pattyka/plasmapen-nexus/tools/out/f_bottom.png

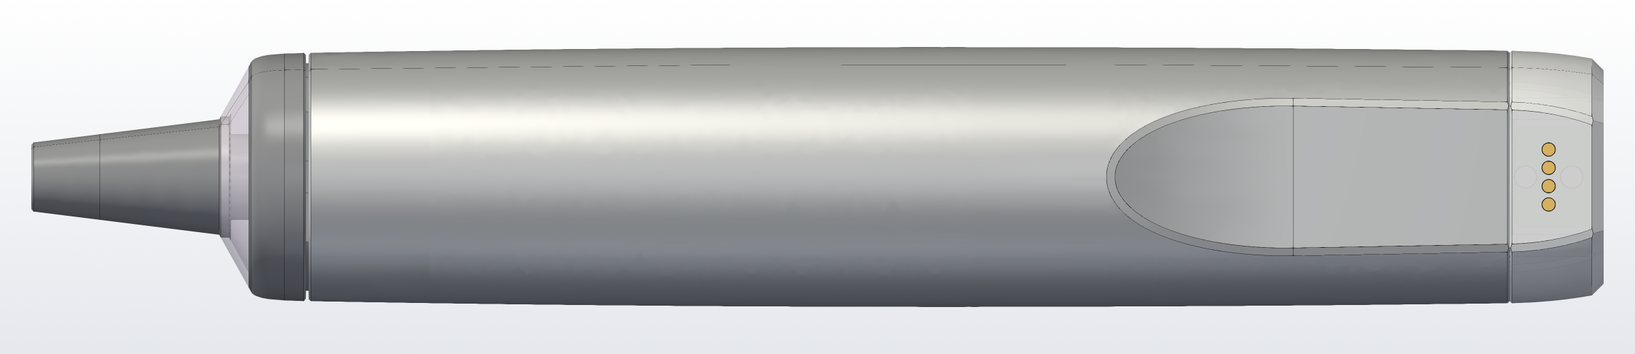
tools/out/f_bottom.png
