pattyka/plasmapen-nexus/tools/out/b_cutaway_side.png

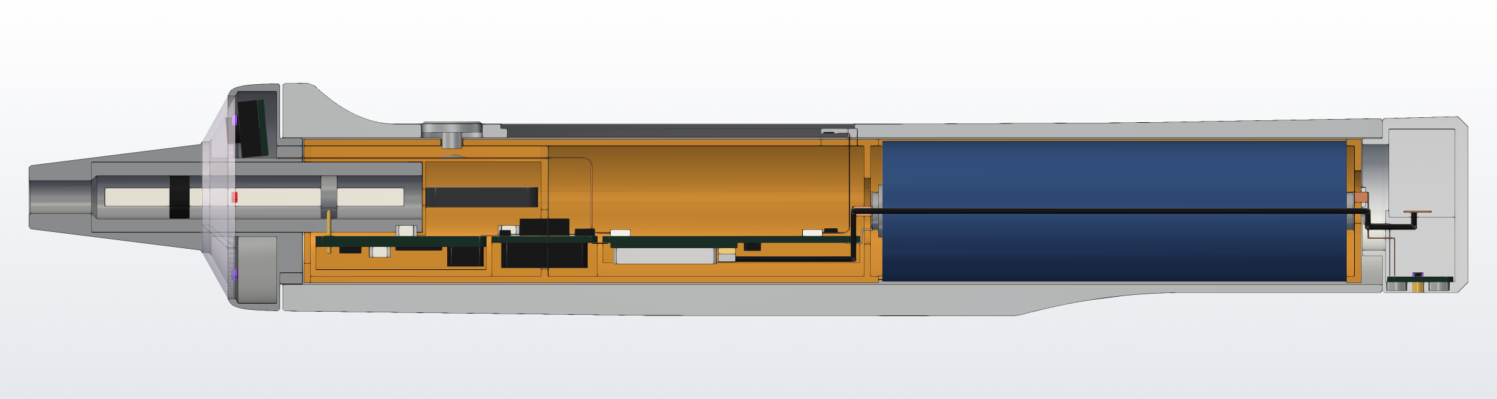
tools/out/b_cutaway_side.png
