pattyka/plasmapen-nexus/BRIEF.md

# PlasmaPen Nexus — shared brief for every builder

Goal: a parametric Autodesk Fusion model of the PlasmaPen Nexus (handheld cold-plasma wound pen,
see the pitch summary below), generated by a Fusion Python script. ONE Fusion design contains:
  • "működés" (render) assembly — pen pointing down at a petri dish, plasma plume on, LEDs glowing
  • "engineering" assembly — same pen lying horizontal, shells cut in half (z > 0 removed) so the
    internals are visible. Internal parts are SHARED components (same component, second occurrence),
    shells are built twice (once whole, once cut).
Quality bar: Apple-grade industrial design, real part dimensions, renders that look like a product
page. Plain, restrained, no fake detail. Production-ready code: no TODOs, no stubs.

Pitch facts: 280 g target, 5–8 W, < 38 °C plasma, TDK CeraPlas piezo, 405 nm blue LED (+ 660 nm
aux) excites porphyrin (red) / pyoverdine (green) fluorescence, Omnivision OV5640 camera + filter
in the head, ESP32-S3 (BLE) does closed-loop dosing, one button, 21700 Li-ion 4800 mAh, CNC
aluminium body + PEEK head. Demo: KI-starch strip, BSL-1 agar plate (E. coli K-12 / B. subtilis).
Revision 4 deviations (reasons in "REVISION 4"): CeraPlas HF instead of F (5 W), 1.91" touch
AMOLED instead of the 0.96" OLED, no USB-C (4-pad dock), two galvanically separated boards.

## Files (folder ~/Documents/PlasmaPen/)
  PlasmaPenNexus/PlasmaPenNexus.py   Fusion entry point / orchestrator (owner: lead)
  PlasmaPenNexus/pp_params.py        ALL user parameters (owner: lead) — read it first
  PlasmaPenNexus/pp_core.py          Backend interface + FusionBackend (owner: agent K) — read it
  PlasmaPenNexus/pp_shell.py         Package S — alu housing, end cap, cover glass, button
  PlasmaPenNexus/pp_head.py          Package H — PEEK nose cone, HV liner, piezo, optics
  PlasmaPenNexus/pp_insert.py        Package H — PEI insert (sled), bulkheads, shield foil
  PlasmaPenNexus/pp_electronics.py   Package E — boards, display, cell, blower, dock, antenna
  PlasmaPenNexus/pp_scene.py, pp_looks.py, assets/oled_ui.png   (unchanged; looks: see below)
  tools/preview_backend.py, tools/preview.py, tools/check.py    preview + checks (agent K)
  pp_body.py, pp_internals.py are REVISION 3 and obsolete: no list loads them. Delete them once
  pp_shell / pp_insert / pp_electronics exist (lead). tools/head_section.py and
  tools/internals_check.py import pp_body and die with it.

## Rules for builder modules (S, H, E)
- Import only `pp_core` helpers (`neg`, `Op`) and talk only to the `bk` Backend object. NEVER import
  adsk. Never call methods not in the Backend interface. Do not import another builder module.
- Every size/coordinate is a Fusion expression string built from parameter names in pp_params.py.
  Every literal length carries " mm" ("2.5 mm"), angles " deg". Unitless counts are bare.
- If you need a NEW parameter, do NOT edit pp_params.py. Declare it in your module as
      EXTRA_PARAMS = [("name", "expr", "mm", "Rövid magyar komment"), ...]
  (prefix names with your module: shell_*, head_*, ins_*, el_*, scene_*). Expressions may reference
  pp_params names and your own earlier EXTRA_PARAMS only — never another module's. A module check
  is named <prefix>_chk_* and must stay ≥ 0 (the orchestrator and check.py report every chk).
- Profiles are closed loops in the component XY plane (see pp_core docstring). Fully think through
  the geometry: no zero-length segments, no self-intersection, no coincident duplicate vertices,
  no point that changes side of an axis when parameters vary over the check.py variants.
- Revolve profiles about the X axis must lie entirely at y ≥ 0 and touch y = 0 only on purpose.
- Name every component and body in short Hungarian (e.g. "Orrkúp (PEEK)", "Üveggyűrű"), like Apple
  would label parts: plain nouns. Component names listed in the contracts below are fixed
  (check.py matches some of them).
- Looks / materials: use keys from this list (pp_looks.py):
    looks:     alu, alu_dark, peek, pei (amber translucent insert), glass_window (violet-tint
               clear ring), glass_black (cover glass), glass_frost (end cap light guide), lens,
               led405, led660, plasma_core, plasma_halo, spot405, ceramic, pcb, shield, copper,
               gold, steel, battery_wrap, plastic_black, plastic_white, rubber, fan, agar, petri,
               oled_on
    materials: aluminum, peek, pei, glass, plastic, steel, copper, fr4, battery
- Pass pen=False for scene bodies (plume, dish, agar, spot) so they stay out of the mass report.
- Edge breaks: `bk.fillet(comp, name, body, edges, radius)` and
  `bk.chamfer(comp, name, body, edges, distance)` (equal distance). Both take the same selector
  list, chain tangent edges, and are cosmetic: a failure is logged, returns None, never stops the
  build. Selectors (tolerance 0.05 mm, only edges of `body`):
    ("circle", x, r)          arc/circle centred on the X axis at x, radius r
    ("line_y", x, z) / ("line_x", y, z)   straight edge parallel to Y / X through that point
    ("plane_y", y)            every edge lying entirely in the plane y = value
    ("plane_y", y, 1 | -1)    … only on the z > 0 / z < 0 side (an edge on z = 0 is excluded)
    ("op_edges", op)          every edge bounding a face that `op` (an Op you got back earlier,
                              e.g. the cut that made the facet) created, looked up when the
                              fillet/chamfer runs, so later ops are followed
    ("op_edges", op, "outer") … only where those faces meet the rest of the body: the rim of a
                              sliced flat or pocket, without the edges inside the pocket
    ("plane_x", x)            every edge lying entirely in the plane x = value
    ("minus", sel_a, sel_b)   what sel_a matches minus what sel_b matches, e.g. a facet rim
                              without its edge on the joint face
  Keep the Op of every cut you want to break later (`flat = bk.box(..., op="cut", ...)`).
- `bk.count(expr)` → int value of a unitless parameter now, for a row of N features in a loop
  (dock pads). Fusion moves them on a later parameter edit but never adds or removes one.
- Edges the revolve profile can carry (joint chamfers, the Kamm chamfer at the tail) go INTO the
  profile as a 45° segment, not into a chamfer feature: it cannot fail.

## Module contracts
  pp_shell.py:       build_shell(bk, parent, cutaway) -> ["Ház (alu)", "Hátsó kupak (PC)",
                                                          "Fedőüveg"]
                     build_shared(bk, parent) -> ["Gomb"]
                     outer_r(x) -> str   Fusion expression of the housing/cap outer radius at x
                                         (formula in "Outer form"), for nose_split ≤ x ≤ pen_len
  pp_head.py:        build_shell(bk, parent, cutaway) -> ["Orrkúp (PEEK)", "HV bélés (PEEK)"]
                     build_shared(bk, parent) -> ["Üveggyűrű", "LED 405 nm", "LED 660 nm",
                                                  "Kamera (OV5640)", "CeraPlas HF"]
  pp_insert.py:      build_shell(bk, parent, cutaway) -> ["Betét (PEI)"]
                     build_shared(bk, parent) -> ["Árnyékolás"]
  pp_electronics.py: build_shared(bk, parent) -> ["Plazma NYÁK", "Ventilátor", "Vezérlő híd",
                     "AI NYÁK", 'AMOLED 1,91"', "Akku 21700", "Dokk NYÁK", "Dokk érintkezők",
                     "Mágnesek", "BLE antenna"]
  pp_scene.py:       build_scene(bk, parent) -> list[comp]   (render assembly only, unchanged)
  Build order (orchestrator and preview): build_shell of pp_shell, pp_head, pp_insert; then
  build_shared of pp_shell, pp_head, pp_insert, pp_electronics; then the scene. Engineering copy:
  build_shell(cutaway=True) of the same three + a second occurrence of every shared component.
  When cutaway is True, after building, call bk.cut_half(comp, "Metszet", [bodies...]).

## REVISION 4 — what Patrik asked for (2026-10-21)
Rejected revision 3 (Ø29 spindle, 1.1" strip, rounded facet). Wants: Pininfarina method, thicker
body with substance (several cm if engineering-real, not a writing pen), a long cylinder
(toilet-paper roll) with the TOP sliced flat for a substantial touch AMOLED and the BOTTOM sliced
flat for pogo-pin dock contacts, CHAMFERED edges, a very elegant end cap, streamlined / organic /
dynamic (may look generative). Two-part device: the case, and inside it a separately built PLASTIC
INSERT that slides in; inside the insert physically separated electronics for (1) the AI camera
and (2) the plasma, two complete boards talking through an integrated controller; the plastic
insulates the user from a short. Display under the THUMB, visible during use. Apple product, not
homemade. Parametric, so the inside survives parameter changes.

## REVISION 4 — research
Pininfarina, sourced (statements) → the rule we apply:
- One or two pencil lines. Borgogno, Battista Geneva 2019 press kit: "the car can be sketched with
  just one or two lines of a pencil - a single line defines the Duetto or Cisitalia".
  [KIT] zmfqrnenekgkedngmqke.supabase.co/storage/v1/object/public/media/automobili-pininfarina/
  20190304_EN_PININFARINA_BATTISTA__THE_WORLDS_FIRST_PURE_ELECTRIC_LUXURY_HYPER_GT_REVEALED.pdf
  → the side view is ONE tensioned line (two parabolas meeting with zero slope at x_max), plus
  the two flat cuts. Nothing else is drawn on the side.
- Lines only where volumes change. CAR on the Sergio: "every line marks a transition from one
  volume to another" (carmagazine.co.uk … pininfarina-sergio-concept-2013-first-official-pictures)
  → exactly three ring lines: the glass chamfer (beak → body), the nose | housing joint, the
  housing | cap joint. The facet chamfers are the only other lines and they are volume changes.
- Hide the technology. [KIT]: "fewer obvious openings… more area for bodywork surfaces… instead of
  gaps and holes"; wing joined "without shut-lines". → no vents, no screws, no USB-C, no labels.
  The air intake IS the nose | housing shadow gap; the dock is on the underside of the cap.
- Shapes cut by moving air, curved or sharp at the edges (Battista Pininfarina watching snow,
  carrozzieri-italiani.com/pininfarina-wind-tunnel-where-wind-shapes-beauty; wind tunnel 1972).
  Soft surfaces that slide rearward (Bonzanigo, autodesignmagazine.com/en/2019/03/ap-battista-by-
  pininfarina-elogio-della-fluidita) → a soft revolved volume, sharp chamfers only where a plane
  cuts it. Chamfers, never fillets, on the exterior (Patrik's call matches this).
- Decoration has a hard limit: one thin aluminium line, "the limits of decoration"; one signature
  colour [KIT] → ONE accent: the violet glass chamfer ring at the nose. It is functional (LEDs +
  camera window), so it is not decoration.
- Light that reports status: the Battista charge port "light bar… pulses… indicating the charge
  status" [KIT] → the end cap is a frosted PC light guide; the dock board's LED lights the cap.
- "The secret is to be simple" (Amantea, news.dupontregistry.com/features/interview-automobili-
  pininfarinas-chief-design-officer-dave-amantea).
- Products: Segno Primina, turned aluminium, "slim barrel subtly tapers to the writing tip…
  conical" (calligraphy.co.uk/pinifarina-forever-primina); Cisitalia 202 doors "sketched onto the
  surface" (carrozzieri-italiani.com/cisitalia-202); Modulo: two shells split by one straight
  groove (rmsothebys.com/auctions/pf22/lots/n0001-modulo-70s). Medical: only Medesy LEVANTE dental
  handles (medident.com.au/brands/medesy-levante). "Design Writing" as a term was not found in any
  source; it is not used here.
Inferred by us (no Pininfarina number exists): thickest point at 58 % of the length from the tip
(teardrop, mass forward of the tail), radius change ≤ 1 mm over the whole body (tension you see
as a light gradient, not as a shape), chamfer 0.6 mm on the facets, 1.6 mm Kamm cut at the tail.

Ergonomics (sourced):
- Power grip Ø 40 mm, range 30–50; precision 8–16 (CCOHS, ccohs.ca/oshanswers/ergonomics/handtools/
  tooldesign.html). Kong & Lowe 2005: 30/35/40 mm rated most comfortable, optimum 19.7 % of hand
  length (stacks.cdc.gov/view/cdc/197408) → 31.5 mm (5th % woman, hand 160 mm) … 40 mm (95th % man,
  205 mm; personal.cityu.edu.hk/meachan/Online Anthropometry Ch2-28). Ø36 is inside for everyone.
- Patkin: fingertip ~2 cm from an instrument tip, handle from fingertips to the thumb cleft
  ~10 cm, centre of gravity between the two (mpatkin.org/surg_micro/erg_micr_instrum.htm). Hakko
  FM-2032: tip-to-grip 50 mm. CCOHS: ≤ 0.4 kg for precision tools, centre of gravity at the hand.
- Comparable thick handhelds with a top display: Braun ThermoScan 7 145 × 36 × 55 mm, "large LCD
  screen on the top" (choice.com.au … braun-thermoscan-7-irt-6520); Butterfly iQ3 152 × 52 × 37 mm.
- At Ø36 the grip is thumb-on-top (thermometer / toothbrush grip), fingers wrapped underneath. So
  the top flat is under the thumb, not under the index finger, and stays visible behind it.
  Recommended thumb pad centre ≈ 65 mm from the tip (55–75; 26 mm beak + glass ring pushes the
  pencil-grip numbers out). Centre of mass 95–125 mm.

Components (datasheet numbers):
- Display: 1.91" AMOLED 240 × 536, RM67162 (QSPI), touch FT3168 (Waveshare ESP32-S3-Touch-AMOLED-
  1.91, waveshare.com/esp32-s3-amoled-1.91.htm; drawing …/ESP32-S3-Touch-AMOLED-1.91-details-
  size-2.jpg: cover glass 26.40 × 57.52, visible 20.40 × 44.82, R2.5). Bare panel Everdisplay
  EDO191-240536: 22.4 × 51.32, active 19.8 × 44.22 (marketplace.oled-info.com/view/173). We use
  our own 0.7 mm cover glass 24.4 × 53.32. Panel + touch thickness was NOT published: 1.25 mm is
  our assumption (Crystalfontz 1.93" with touch is 2.11 incl. its cover); verify with the supplier.
  2.06" (CO5300, 33 × 40.5 visible) and 1.8" are wider than any flat Ø36 can carry.
- Piezo: TDK CeraPlas HF B54310N5100A010: 45.2 × 4 × 2.75, 3.8 g, ≤ 7 Vrms, 5 W max continuous,
  ~82 kHz, two Ø0.6 pins 4.6 apart at 11.3 mm from the input end; mount ONLY via the pins, no
  clamping; "the housing material must be non-conductive". F series B54320N5100A010: 70.6 × 6 ×
  2.75, 9 g, 12 Vrms, 8 W. TDK driving-circuit user guide: "Avoid electrical conducting materials
  near (less than 20 mm, sharp tips less than 30 mm) the output side", output up to 20 kV.
  (tdk-electronics.tdk.com, Cold_Plasma datasheets + CeraPlas driving circuit user guide.)
- Camera: OV5640 needs an 8.5 × 8.5 × < 6 mm module (OmniVision via acmesystems.it/www/
  roadrunner_isc/OV5640.pdf). No smaller OV5640 module exists. This sets the front diameter.
- MCUs: AI board ESP32-S3-WROOM-1U-N16R8, 18 × 19.2 × 3.2, 16 MB flash + 8 MB octal PSRAM, DVP
  camera, ESP-DL, u.FL (MINI-1 has only 2 MB PSRAM — too little for vision). Plasma board
  STM32G474, UFQFPN48 7 × 7, HRTIM 184 ps for the phase-locked piezo drive (G431 has no HRTIM).
- Isolation ("integrated controller" = Vezérlő híd): TI ISO7741 (3 fwd + 1 rev = SPI, 100 Mbps,
  5 kVrms in wide SOIC-16 10.3 × 10.3; ti.com/product/ISO7741); TI SN6507 push-pull transformer
  driver 3–36 V, 2 × 0.5 A switches, HVSSOP-10 3 × 3 (ti.com/product/SN6507) + Würth WE-PPTI
  size-1308 transformer made for it (750319692; outline not found — 13 × 8 × 4 reserved, verify).
  12 V × 0.5 A → ~5 W isolated for the plasma island.
- Blower: Sunon UB3H3-700, 17 × 17 × 3, 3 V, 6.5 l/min, 40 Pa, 0.1 W (chipdip.ru/product0/
  8004579082; rs-online 2883943) → ~5.5 m/s through the Ø5 nozzle.
- Cell: Samsung INR21700-50E, max Ø21.25 × 70.80, 69.5 g, 4900 mAh = 17.8 Wh, 9.8 A
  (shop.aceongroup.com … Samsung_50E_DATASHEET.pdf). Draw ~7.5 W → ~2.3 h of plasma.
- Dock: device carries flush gold target pads; the dock carries Mill-Max 0906 spring pins (2 A
  cont., 0.70 mid / 1.40 mm max stroke, 1 M cycles; mill-max.com catalog 023-028.pdf). 4 pads:
  V+ 5 V, GND, UART TX, RX. Targets on the device = nothing springy or open to fluids on a
  medical device that gets wiped. Two N52 magnets Ø3 × 1.5 align it.

## REVISION 4 — architecture (decided)
Overall: 217.7 × Ø36 mm; section 36 wide × 29 tall at the display, 36 × 25.5 at the tail where
both flats exist; ~205 g
(estimate; check.py measures), centre of mass ~110 mm from the tip. Ø36 is the floor, not a style
choice: at Ø34 the OV5640 no longer fits under the collar, the flex tunnel closes and the dock
pads leave the flat (chk_cam_out, chk_tunnel, chk_dock_w go negative). The F element needs Ø37
and makes the pen 236 mm.

Case = 3 parts:
- "Orrkúp (PEEK)" black PEEK 450G, machined. Non-conductive because of TDK's 20 / 30 mm rule:
  the alu starts at body_x0 = 38.4, its inner edge 31.3 mm from the HV end (chk_hv_alu). Slim beak
  (Ø9.5 → Ø16 over 26 mm) with the nozzle, then the big front chamfer: a 61° conical ring face
  (26 → 31 mm, r 8 → 16.95) carrying the violet glass ring with the camera at θ = 0 and 3 × 405 +
  3 × 660 nm LEDs at r 13.5 behind it, then a short collar to the joint. The beak is slim so the
  user sees the spot past it and the camera sees the wound down to the plume edge (chk_cam_view).
- "Ház (alu)" 6063-T6 extrusion: the interior is a constant double-D bore (circle bore_r 16, flats
  at y = bore_top 9.02 and y = −bore_bot −13.23) with two rail grooves at z = ±bore_r. The outside
  is CNC-machined (revolve + two flat cuts + chamfers), bead-blasted, anodised. Open both ends.
- "Hátsó kupak (PC)" frosted optical polycarbonate light guide, RF-transparent: carries the dock
  pads + magnets on its bottom flat, the dock/charger board, the BLE antenna and the status LED
  (the whole cap glows: charging, dose done). Kamm tail: flat back face, 1.6 mm chamfer.
- "Fedőüveg" 0.7 mm aluminosilicate, bonded into the top flat; the AMOLED is laminated under it.

Insert = "Betét (PEI)", injection-moulded PEI (ULTEM 1000 type), natural amber, 1.0 mm walls.
Its outside is the bore section minus 0.25 mm (prismatic, so it slides the full length); two ribs
ride in the rail grooves. The nose cone clips onto the insert's front wall B0 and the HV liner
passes through it, so nose cone + insert + everything inside is ONE cartridge that slides into the
housing from the front; the cap's spigot bayonets into B3 at the back and clamps the housing between
the nose collar and the cap. Then the display drops into the top pocket (FPC plugs into the AI
board through the panel window) and the button snaps in from outside. Compartments:
  P (plasma island, galvanically isolated): HV liner + CeraPlas HF, plasma board under the liner,
     blower. Between B0 and B1. Air enters through the nose shadow gap (nose_gap 0.4) only.
  A (user side): optics chamber in the nose cone, the flex tunnel on top of the P compartment
     (its own sealed channel, PEI floor 0.5 over the 2 mm PEEK liner), the AI bay (B1 → B2),
     the battery bay (B2 → B3, open top and bottom; the cell's Kapton sleeve faces the alu), the
     cap. Battery, dock, display, touch, camera, button and antenna are all A: every conductor a
     user can touch or plug is on the far side of the barrier from the 20 kV.
  Barrier: B1 + the tunnel floor. The bridge board passes through a sealed window in B1; the
  ISO7741 and the transformer straddle B1's plane. Copper shield foil on B1's A face and the
  anodised housing both tie to A ground (Faraday cage for the 82 kHz drive).
The one capability nobody asked for: vision dose-lock. The camera sits 10.5 mm off-axis, so the
660 nm LED spot moves in the image with distance; the AI board computes the standoff and the
bridge's hardware AND only lets the plasma run while the button is held AND 9 mm ≤ standoff ≤
12 mm. That also guarantees TDK's 20 mm between the HV tip and the patient (chk_hv_target), and
the display under the thumb paints a live coverage map of the dose.

## REVISION 4 — layout (default parameters; pp_params.py is the truth — ExprEval it)
X = axis, x = 0 nozzle face, +X back. Y up = display flat, −Y = dock flat. Z side; cut = z > 0.
  x 0 … 26        beak (PEEK), r tip_r0 4.75 → face_r0 8, straight cone; nozzle bore Ø5 to 9.5.
  x 9.5 … 59.5    HV liner (PEEK) bore r 3.28 (= piezo half-diagonal + 0.85), wall 2, r_o 5.28;
                  front funnel Ø5 → bore; rear end open to the blower.
  x 11.5 … 56.7   CeraPlas HF, output (HV) end at the FRONT; pins at x 45.4, z ±2.3, down (−Y)
                  through the liner floor into the plasma board.
  x 26 … 31       glass chamfer ring face (r 8 → 16.95); glass r 8.4 … 15.95, 1.0 thick.
  x 30.3          LED faces, ring r 13.5, θ = ±30°, ±90°, ±150° (405 / 660 alternating).
  x 31.2 … 37.2   OV5640 module, centre y 10.48, 8.5 square, tilted 5° toward the axis.
  x 31 … 38       collar r 16.95 → 17.2. x 38 … 38.4 shadow gap (air intake). Spigot (double-D)
                  38.4 … 41.4 inside the housing bore.
  x 38.4 … 204.72 housing (alu). Outside r: 17.2 at 38.4 → 18.0 at x_max 126.3 → 17.5 at 204.72.
  x 41.6 … 201.52 insert. B0 41.6, B1 77.5, B2 126.32, B3 200.52 (each 1.0 thick).
  x 43.4 … 69.2   plasma board, top face y −5.88, 1.6 thick, 20 wide (STM32G474, half-bridge,
                  resonant inductor, 12 V bus caps on the underside).
  x 60 … 77       blower 17 × 17 × 3 on the axis (y ±1.5), outlet forward into the liner.
  x 70 … 86       Vezérlő híd, top y −5.88, 16 × 16, through B1.
  x 86.8 … 125.72 AI board, top y −5.88, 22 wide, 1.0 thick (ESP32-S3-WROOM-1U on top).
  x 59.5 … 68.5   button Ø9 on the top flat at x 64 (thumb), hold-to-treat.
  x 71.5 … 124.82 cover glass 24.4 × 53.32 × 0.7, flush in the top flat (y 11.07).
  x 72.5 … 123.82 AMOLED 22.4 × 51.32 × 1.25 at y 9.12 … 10.37; active 19.8 × 44.22 from x 74.05.
                  FPC (12 wide) leaves the back end and drops to the AI board.
  x 41.6 … 77.5   A flex tunnel on top: 9 wide, floor y 5.38 … 5.88, roof = insert top (7.77).
  x 128.52 … 199.32 cell Ø21.25, axis at y −2.10 (+ at the front).
  x 204.72 … 217.72 end cap; dock pads (row across Z, 2.54 pitch) at x 210.12 on the bottom
                  flat; magnets at x 210.12 ± 3.2 on the axis.
  top flat        y 11.07, starts at 42 (fade), flat 55.5 … 130.8, rises 1.2 mm to the tail.
                  Width 27.1 at the button → 28.4 at x_max → 24.4 at the tail: a long drop.
  bottom flat     y −14.43, fades in 146.7 … 174.7, flat to the tail, width ~20.
  x < 0           plume, dish.

## Outer form (Package S implements, the formulas are fixed)
  front  x ∈ [nose_split, x_max]:  t = (x − nose_split) / (x_max − nose_split)
         r = body_r0 + (body_r − body_r0) · (1 − (1 − t)²)          (zero slope at x_max)
  rear   x ∈ [x_max, pen_len]:     u = (x − x_max) / (body_end − x_max)   (u > 1 on the cap)
         r = body_r − (body_r − body_rt) · u²
  Splines through ≥ 8 points of each formula (as revolution 3 did for the ogive). The cap continues
  the rear formula, so the joint at body_end is G1.
  Top cut (one side-view profile, extrude_sym across Z, applied to the housing AND to the cap):
  above the line (tc_x0, outer_r(tc_x0) + 0.8) → spline, horizontal at its end → (tc_x1, top_y)
  → line → (tc_x2, top_y) → spline rising, horizontal at its start → (pen_len + 1, top_y +
  top_rise). Bottom cut: below (bc_x0, −(outer_r(bc_x0) + 0.8)) → spline → (bc_x1, −bot_y) →
  line → (pen_len + 1, −bot_y). Then chamfer ("op_edges", cut, "outer") by top_ch / bot_ch.
  Because the planes cut a body whose radius changes, both flats come out drop-shaped and their
  chamfer reads as a line of varying width — that is the "generative" quality, earned by geometry.

## Verification
There is NO Fusion on this machine. tools/preview_backend.py (CadQuery) runs the same builder
modules:
  uv run --python 3.12 --with cadquery --with matplotlib --with numpy python tools/check.py
  uv run --python 3.12 --with cadquery --with matplotlib --with numpy python tools/preview.py
check.py: build errors, interference, electronics inside the bore section (except AMOLED and the
cap parts), silhouette, mass + centre of mass, every chk_*, robustness over the SUBSET variants
(Ø35 / Ø38, CeraPlas F + Ø37, 18650 cell, thumb 58 / 70, standoff 9 / 12, nose_split 37 / 39,
max_frac 0.5 / 0.65, shorter display, 2 / 4 LED pairs). Every variant must build clean.
For plotting use `uv run --python 3.12 --with matplotlib ...` (never pip install into system).

## Package S — shell (pp_shell.py)
Builds "Ház (alu)", "Hátsó kupak (PC)", "Fedőüveg" (build_shell) and "Gomb" (build_shared).
Exposes outer_r(x) (Fusion expression string of the formulas above).
1. Housing, x body_x0 … body_end. Revolve the tube: outer = front/rear splines, inner r = bore_r,
   joint_ch 45° segments in the profile at both outer ends. Join the two flat-wall segments of the
   bore: box x body_x0 … body_end, y bore_top … bore_r + 1, z ±sqrt(bore_r² − bore_top²), and
   the mirror at the bottom (y −bore_r − 1 … −bore_bot); then a revolve cut of everything outside
   the outer line (profile: outer line → r = body_r + 3) removes the box corners. Rail grooves: two
   box cuts y ±rail_w/2, z bore_r − 0.3 … bore_r + rail_d (and the mirror), full length.
2. Top cut + bottom cut (profiles above), chamfer their "outer" op_edges (top_ch, bot_ch).
3. Glass pocket: x glass_x0 − glass_c … glass_x1 + glass_c, width glass_w + 2 glass_c, depth
   glass_t, corners glass_r + glass_c (line_y fillets). Panel window: x oled_x0 − 0.1 … oled_x1 +
   oled_fpc_bend (the FPC wraps round the panel's back edge there), width oled_w + 0.2, from the
   pocket floor down through bore_top (open to the bore).
4. Button hole Ø btn_d + 0.3 at btn_x through the top wall (revolve about a vertical segment).
5. Cap, x body_end − cap_spigot … pen_len, look glass_frost, material plastic: revolve with the
   rear formula outside, the Kamm chamfer cap_ch at the back face as a profile segment, joint_ch at
   the front, a round spigot r ≤ bore_top − 0.15 into the bore (bayonet lugs: two boxes on the
   spigot at θ = ±90°, they engage B3; H cuts the matching slots). Hollow: r 8 through the spigot,
   a dock pocket x body_end + 0.5 … pen_len − cap_rear, y −bot_y + cap_floor … −2, z ±8. Same top
   and bottom cuts + chamfers as the housing. Dock pad holes: dock_pins × Ø dock_pad_d + 0.1 at
   x dock_xc, z = (k − (dock_pins − 1)/2) · dock_pitch, from the flat up to the pocket. Magnet
   pockets: Ø mag_d + 0.1 at x dock_xc ± mag_dx, z 0, from the pocket floor down to mag_skin
   above the flat (blind: invisible from outside).
6. Fedőüveg: box glass_x0 … glass_x1, y top_y − glass_t … top_y, width glass_w, corners glass_r,
   top edge glass_ch chamfer. Look glass_black, material glass.
7. Gomb (shared): revolved about x = btn_x; flat cap Ø btn_d proud btn_proud above top_y with a
   0.3 chamfer, stem Ø3 down through the housing and the insert top to y sled_top_i − 0.4 (dome
   on the tunnel flex). Look alu, material aluminum.
Acceptance: check.py builds pp_shell with 0 errors over all variants; housing wall ≥ shell_wall
everywhere (add shell_chk_wall_tail = body_rt − bore_r − shell_wall); both flats show the drop
shape in tools/preview.py top/bottom views; facet chamfers applied (no fillet_failures for them);
mass of the housing 70–95 g.

## Package H — head + insert (pp_head.py, pp_insert.py)
pp_head build_shell: "Orrkúp (PEEK)", "HV bélés (PEEK)"; build_shared: "Üveggyűrű", "LED 405 nm",
"LED 660 nm", "Kamera (OV5640)", "CeraPlas HF".
1. Nose cone revolve (y ≥ 0): nozzle bore r nozzle_d/2, 0 … nozzle_len; liner socket r liner_ro
   + 0.05 from nozzle_len back through the spigot; beak line (0, tip_r0) → (face_x0, face_r0);
   face line → (face_x1, nose_r1) with the glass recess (win_t deep, r win_r0 … win_r1); collar
   (face_x1, nose_r1) → (nose_split, body_r0) with joint_ch at its rear edge; spigot nose_split
   … body_x0 + nose_spigot, revolved at r bore_r − 0.1 and then cut to the double-D (flats at
   bore_top − 0.1 / −(bore_bot − 0.1)). Optics chamber: annular cavity behind the glass, r
   liner_ro + cam_peek … nose_r1 − 1, back to nose_split − 1, plus the slot to the A tunnel at
   θ = 0 (z ±tun_w/2, y tun_floor … sled_top_i) through the rear wall and the spigot. Air path:
   ≥ 20 mm² from the shadow gap through grooves in the spigot into the P compartment behind B0,
   never within θ = 0 ± 30° (A tunnel) — head_chk_air ≥ 0.
2. HV liner: tube liner_x0 … liner_x1, r liner_ri … liner_ro, 45° funnel from nozzle_d/2 at the
   front, two pin holes Ø cp_pin_d + 0.3 at (cp_pin_x, z ±cp_pin_z) through the floor, rear open.
3. CeraPlas HF (shared, look ceramic, material steel: 7.85 g/cm³ × 0.50 cm³ ≈ the real 3.8 g):
   bar cp_x0 … cp_x1, z ±cp_w/2, y ±cp_h/2; two pins Ø cp_pin_d from the bar down to pcb_y −
   pboard_t − 1 mm; one PEEK pin clip at cp_pin_x and one silicone cradle at cp_x0 + cp_len/4
   (rubber), neither clamps the bar (TDK Fig. 5).
4. Glass ring, LEDs (seeds at θ = ±180°/(2·led_pairs), pattern_x), camera: module = rotated
   rectangle (cam_tilt about Z) extruded ±cam_mod/2, lens barrel revolved about the tilted camera
   axis segment, filter glass (lens look). Sight line: the barrel front must stay behind the glass.
pp_insert build_shell: "Betét (PEI)" (look pei, material pei); build_shared: "Árnyékolás".
5. Sled: revolve tube r sled_ri … sled_r, x sled_x0 … sled_x1, joined with full discs (r 0 …
   sled_r) for B0 / B1 / B2 / B3 (b_t thick at sled_x0, b1_x0, b2_x0, b3_x0); join the inner flat
   walls (box y sled_top_i … sled_top, z ±sqrt(sled_r² − sled_top²), and the bottom mirror); box
   cuts y > sled_top and y < −sled_bot (trims the discs too). Ribs: boxes y ±rib_w/2, z sled_r −
   0.3 … bore_r + rib_h, both sides, full length.
6. Holes: B0 — liner (r liner_ro + 0.1), tunnel passage, air slots (P side). B1 — bridge window
   (bridge_w + 1 wide, pcb_y − 5 … pcb_y + 4), tunnel exit into the AI bay. B2 — cell contact
   window Ø10, coax hole. B3 — Ø8 for the dock flex, bayonet slots for the cap lugs.
7. A tunnel: floor box x sled_x0 … b1_x0, y tun_floor … tun_floor + tun_floor_t, z ±(tun_w/2 +
   0.8) and two side walls 0.8 to the roof. Button hole Ø3.3 at btn_x through the roof.
8. Windows: battery bay top and bottom (x bat_x0 … bat_x1, z ±(bat_d/2 − 1)); display FPC window
   in the roof (x oled_x1 − 4 … oled_x1 + 1.5, z ±(oled_fpc_w/2 + 0.5)). Board ledges: two ribs
   per compartment under the board edges at y pcb_y − pboard_t (plasma) / pcb_y − pcb_t (bridge, AI).
   Blower plenum from the blower outlet to the liner's rear opening.
9. Árnyékolás (shared): copper 0.1 on B1's rear face (look shield, material copper), with the
   bridge window and tunnel exit cut out.
Acceptance: every chk_* of pp_params ≥ 0 and head_chk_* / ins_chk_* ≥ 0 over all variants; no
interference between insert, housing (bore), nose cone, liner, piezo, camera, LEDs; the insert
outer section never exceeds the bore section (ins_chk_fit = sled_c ≥ 0.2 everywhere); the HV
liner + tunnel floor give ≥ 2.5 mm solid plastic between the piezo and any A-side part.

## Package E — electronics (pp_electronics.py, build_shared only) — BUILT
All boards fr4 + pcb look; ICs plastic_black; shields shield; contacts gold; magnets steel.
Every board top face is pcb_y; under the boards pcb_under (4 mm) is guaranteed by bore_bot
(chk_under, el_chk_under), so the transformer / inductor / ESP32 follow any cell or Ø.
1. "Plazma NYÁK": pboard_x0 … pboard_x1, 1.6 thick, CeraPlas pins soldered through it; under:
   2 FETs, gate driver, STM32G474, resonant inductor 5.5 × 5.3 × 3; top: 12 V caps at |z| ≥ 6.8;
   jumper flex to the bridge.
2. "Ventilátor": Sunon UB3H3-700 17 × 17 × 3, inlet on top, outlet toward the liner.
3. "Vezérlő híd": through B1's window; ISO7741 (16 leads, pin rows either side of B1's mid-plane),
   SN6507 on the A side, rectifier + 12 V cap on the P side, WE-PPTI transformer underneath.
4. "AI NYÁK": ESP32-S3-WROOM-1U mounted upside down UNDER the board (frees the top for the two
   FPC connectors wherever the display lands), charger + protection + 3.3 V coil under it, corner
   notch at the rear for the coax, camera flex along the A tunnel with the button's metal dome.
5. 'AMOLED 1,91"': stack + driver shelf + "AMOLED aktív terület" (decal target); the FPC wraps
   round the back edge (needs oled_fpc_bend in S's panel window), FT3168 on its lower leg.
6. "Akku 21700": 50E at y = bat_y; + spring/plate on B2 with a nickel strip through B2's window to
   the AI board's underside; − spring/plate on B3 with a strip through B3's Ø8 hole to the dock.
7. "Dokk NYÁK" (cap pocket) with the status LED, ESD array and the dock flex: cap → B3 Ø8 hole →
   along the cell side (z < 0) → B2 window → AI board. "Dokk érintkezők" 4 × Ø1.8 gold targets
   flush with the dock flat; "Mágnesek" N52 Ø3 × 1.5 (the dock board has clearance holes).
8. "BLE antenna": FXP75 under the dock pocket's roof; Ø0.81 coax from the U.FL under the AI
   board, up through the notch, along the cell (z > 0) through the B2 and B3 coax holes, then IN
   through the "Koax rés" in the cap spigot (pp_shell must cut it: box x shell_cap_x0 − 0.1 …
   shell_cap_x0 + 1.7 mm, y bat_y − 0.6 … bat_y + 0.55 mm, z shell_cav_r − 1 … shell_sp_r +
   0.2 mm), down and back to the feed.
Checks: el_chk_aa, el_chk_aa_w, el_chk_aa_len, el_chk_cf, el_chk_df, el_chk_ai_pack,
el_chk_cx_cav, el_chk_under, el_chk_flex — all ≥ 0 over the variants.
Display UI (assets/oled_ui.png, make_oled_ui.py): PORTRAIT 240 × 536, top edge toward the nose
(the pen points away from the user; the pause control sits at the thumb end).
