pattyka/plasmapen-nexus/PlasmaPenNexus/assets/oled_ui.png

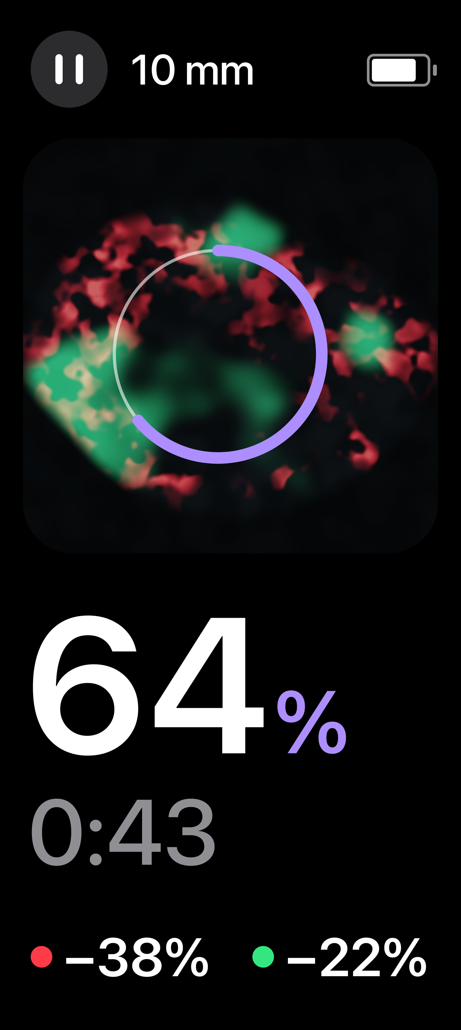
PlasmaPenNexus/assets/oled_ui.png
