pattyka/plasmapen-nexus/tools/out/a_hero.png

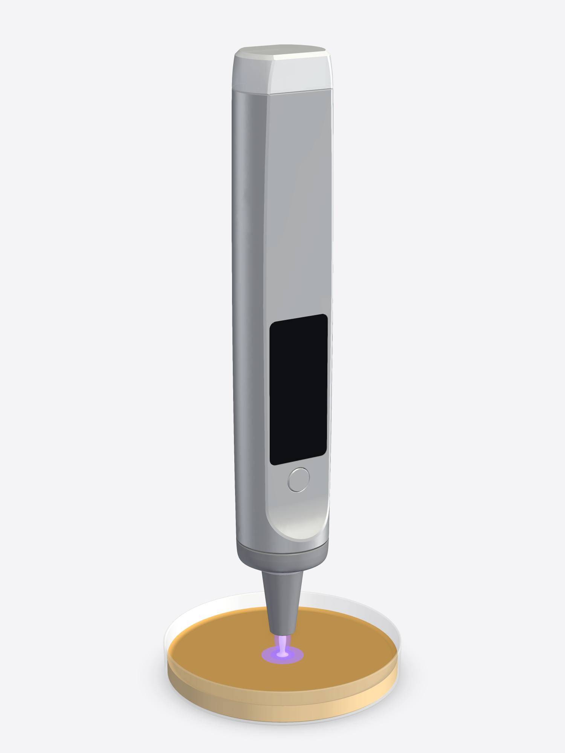
tools/out/a_hero.png
