pattyka/plasmapen-nexus/tools/out/body_details.png

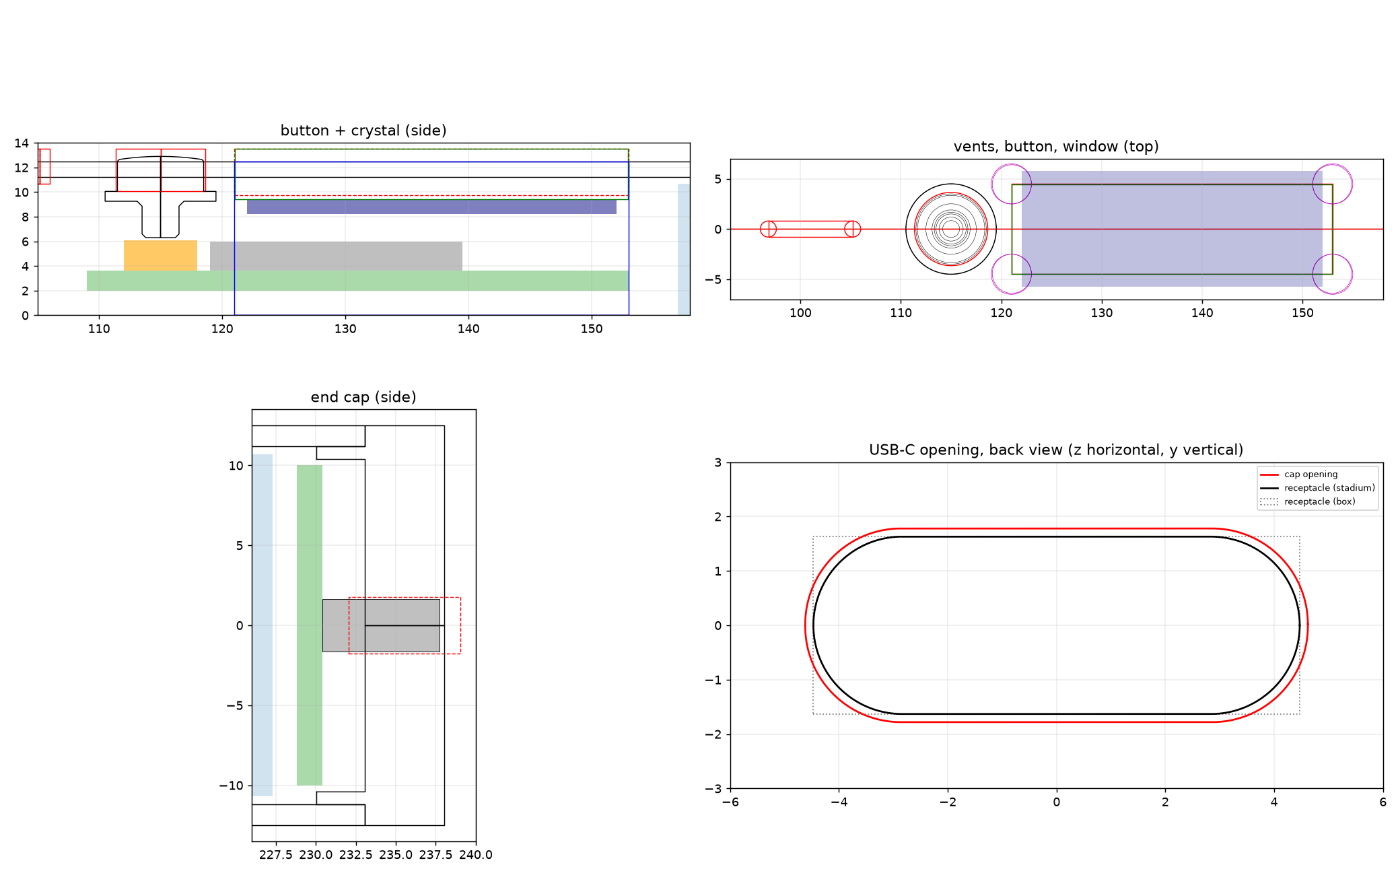
tools/out/body_details.png
