pattyka/plasmapen-nexus/tools/out/body_overview.png

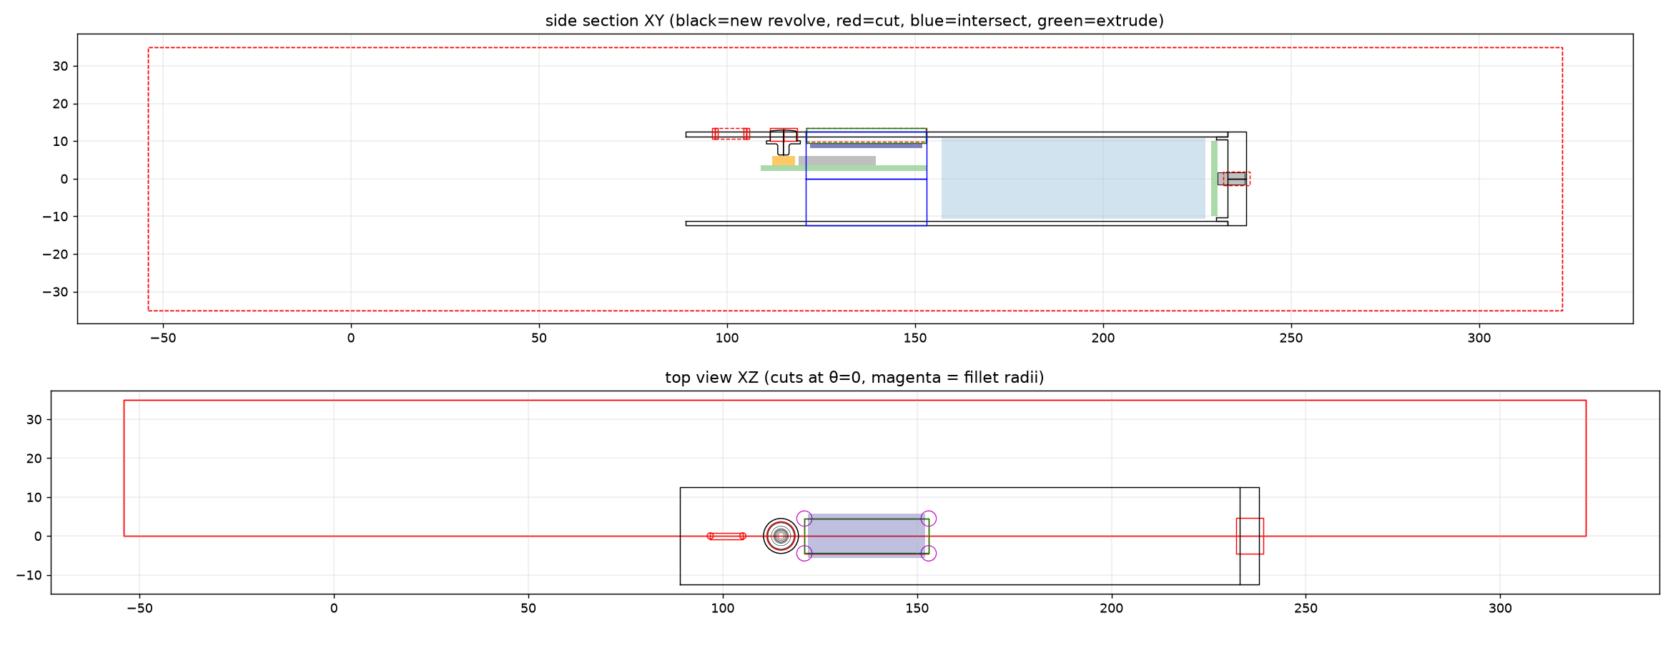
tools/out/body_overview.png
