pattyka/plasmapen-nexus/tools/out/c_cutaway_34.png

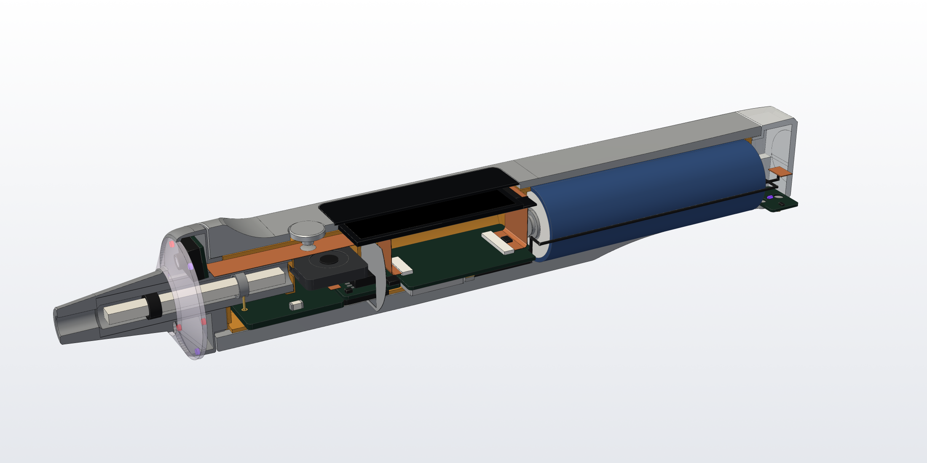
tools/out/c_cutaway_34.png
