pattyka/plasmapen-nexus/tools/out/d_section.png

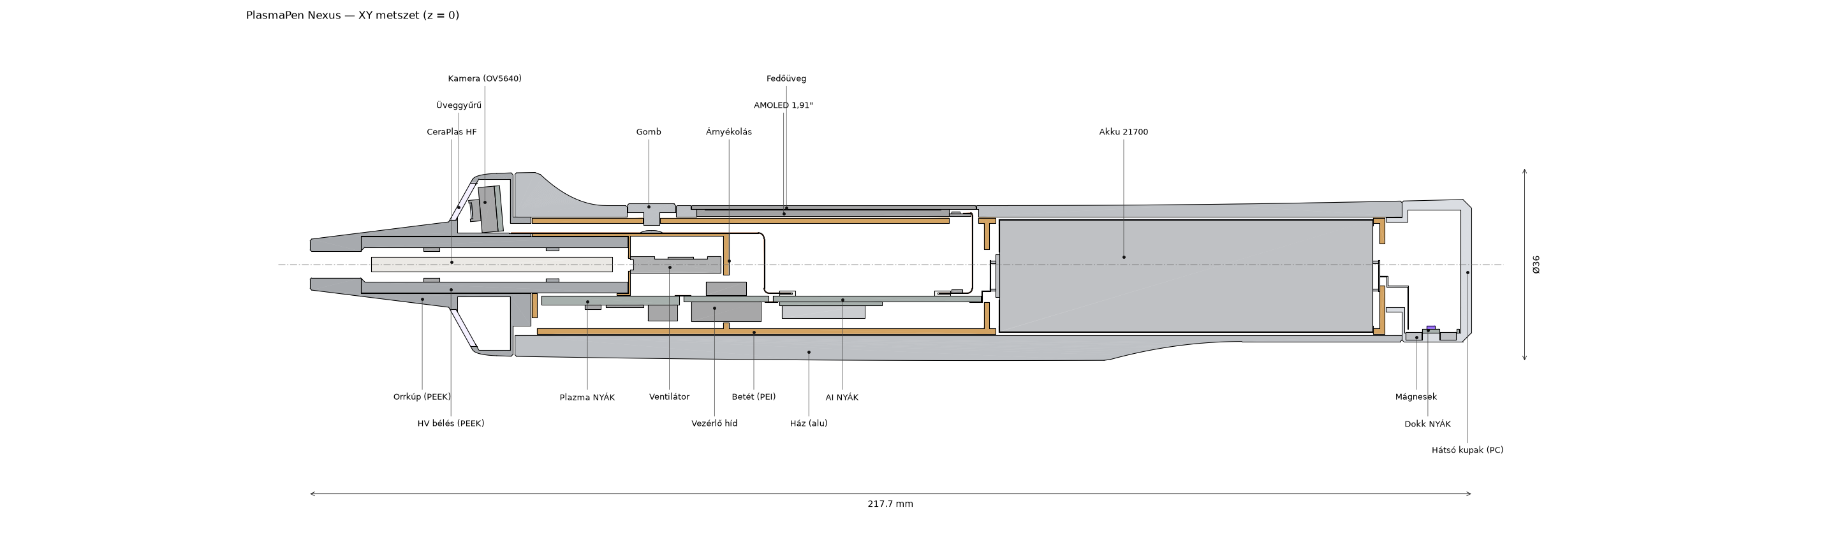
tools/out/d_section.png
