pattyka/plasmapen-nexus/tools/out/e_top.png

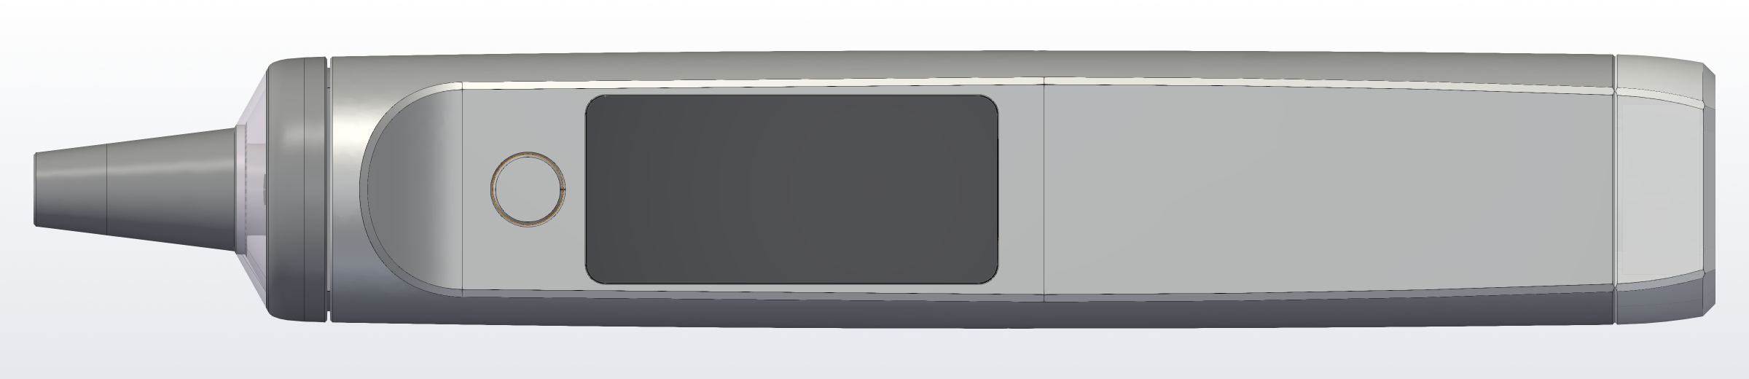
tools/out/e_top.png
