pattyka/plasmapen-nexus/tools/out/g_lying_34.png

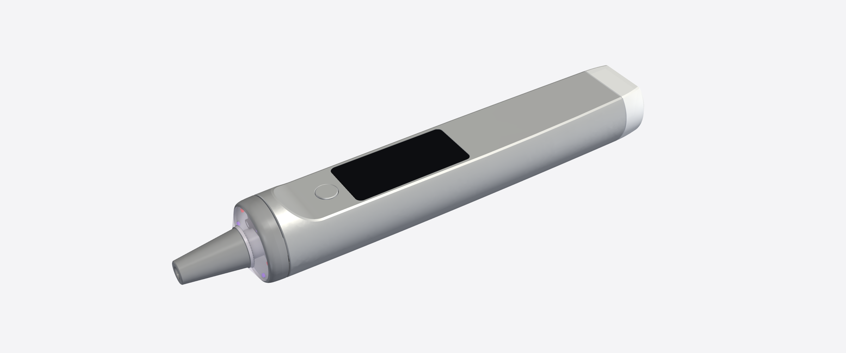
tools/out/g_lying_34.png
