pattyka/plasmapen-nexus/tools/out/head_section.png

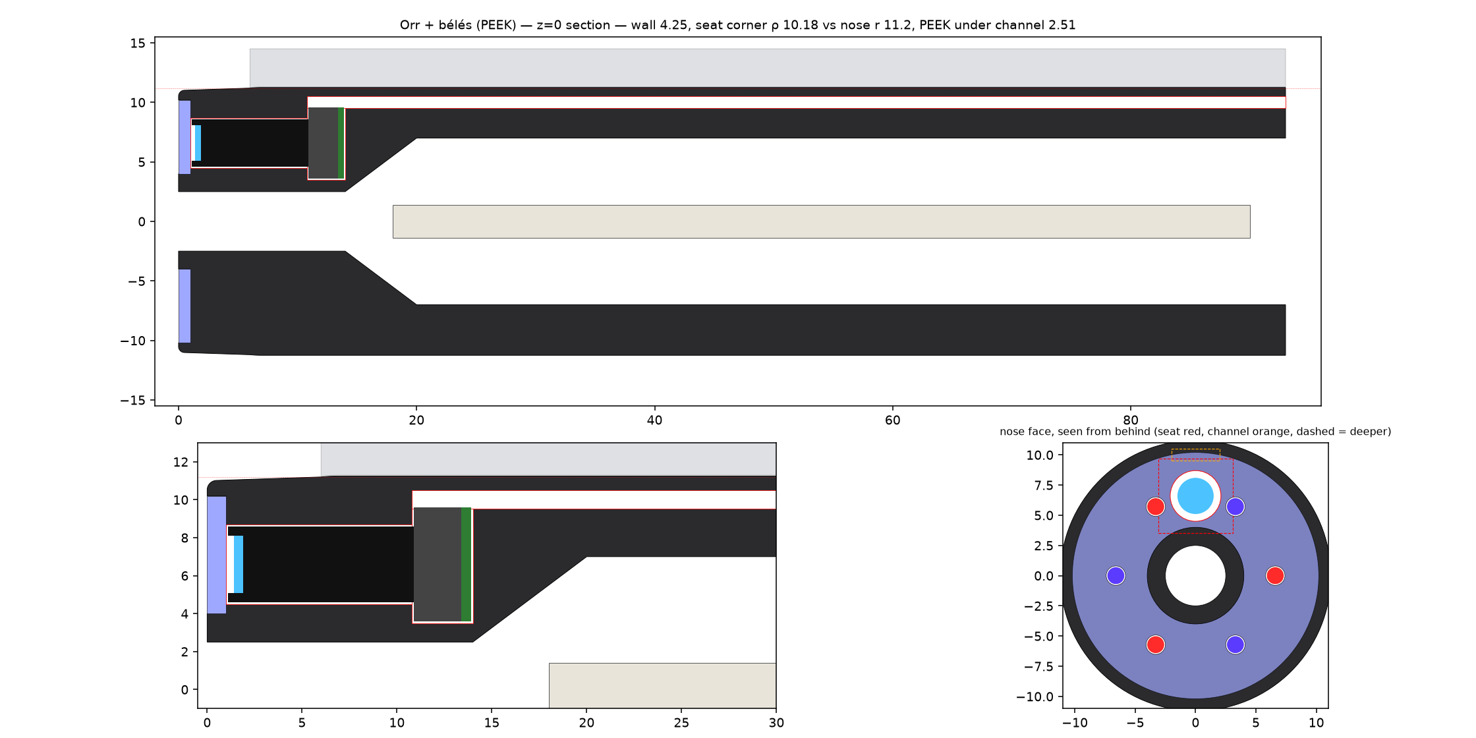
tools/out/head_section.png
