pattyka/plasmapen-nexus/tools/out/internals_sections.png

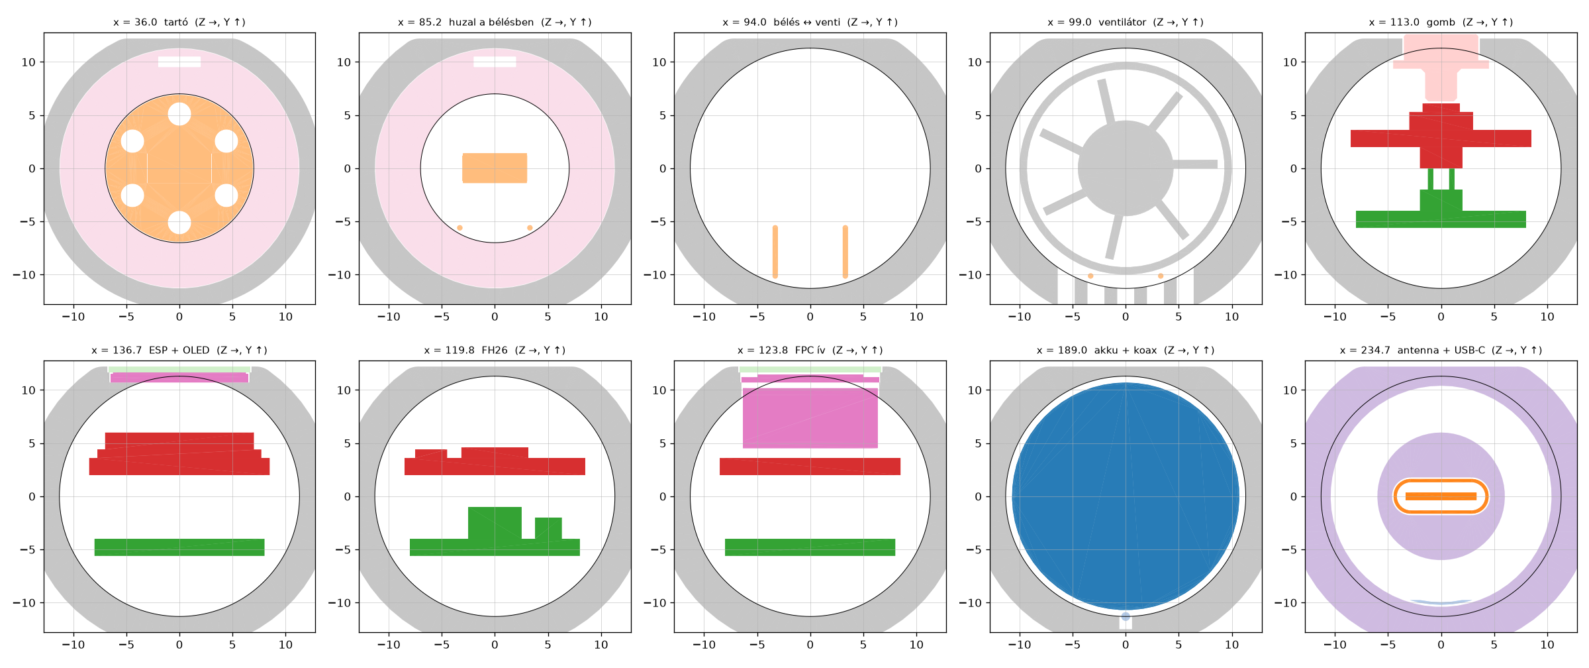
tools/out/internals_sections.png
