pattyka/plasmapen-nexus/tools/out/internals_side_xy.png

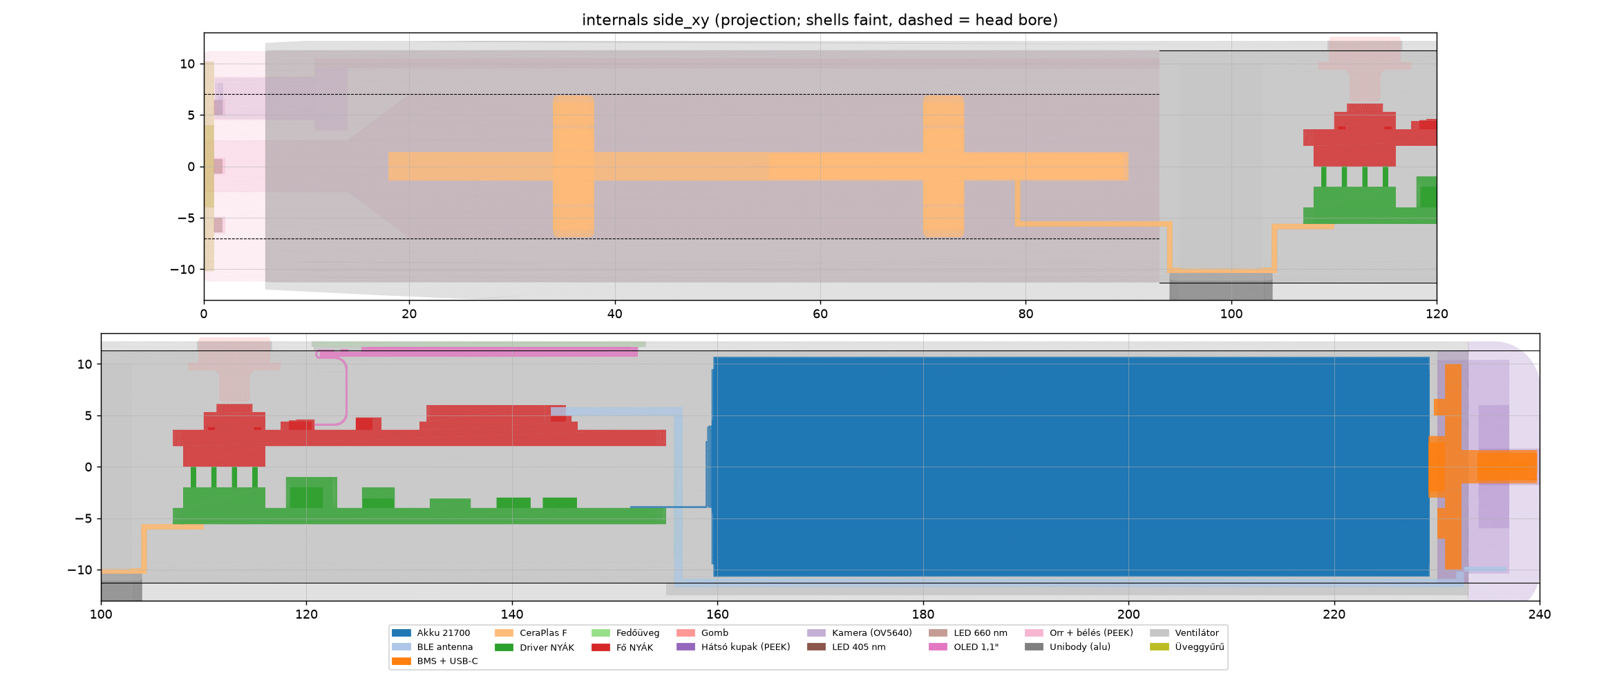
tools/out/internals_side_xy.png
