pattyka/plasmapen-nexus/tools/out/internals_top_xz.png

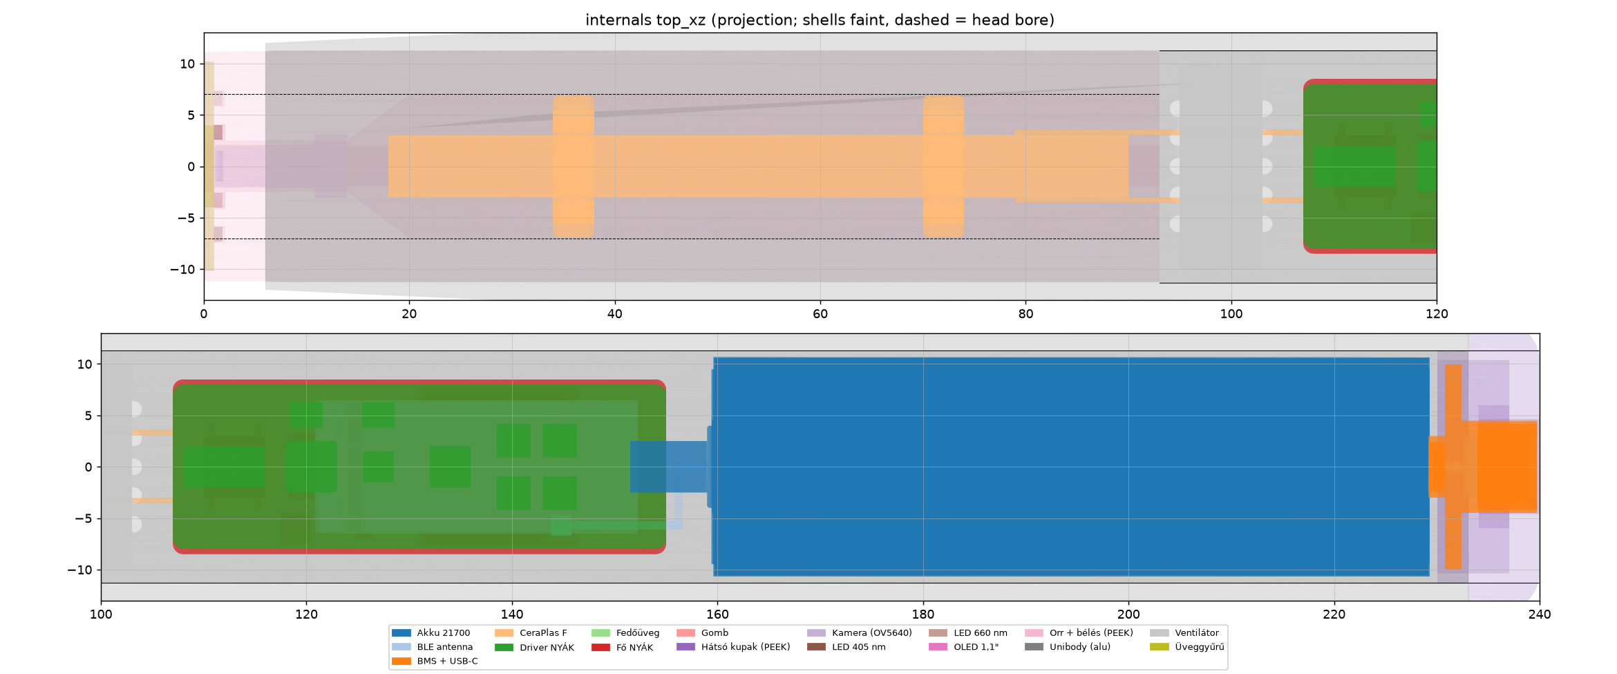
tools/out/internals_top_xz.png
