pattyka/plasmapen-nexus/tools/out/selftest_blend.png

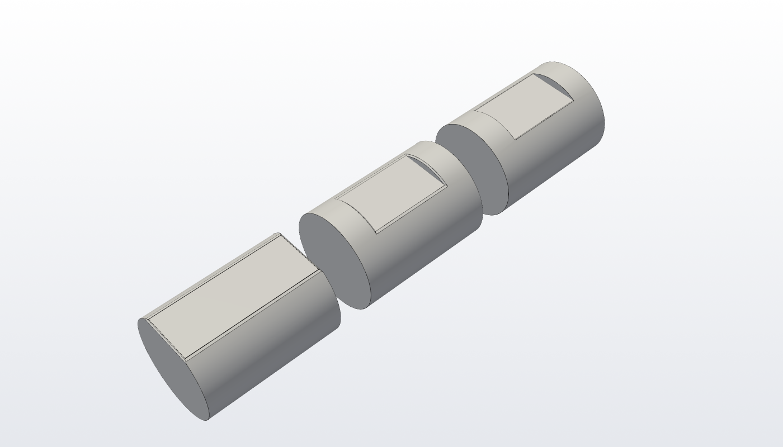
tools/out/selftest_blend.png
