pattyka/plasmapen-nexus/tools/out/preview.step

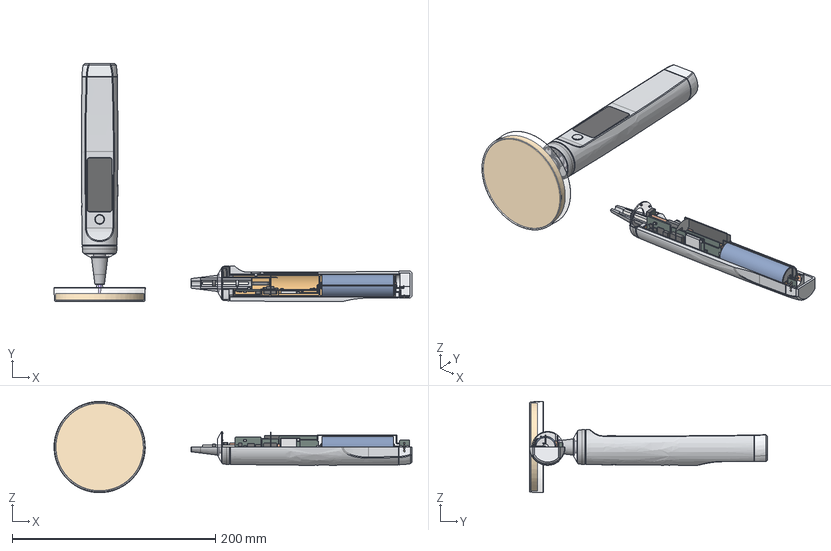
[picture p16: CAD file, 2026-10-21]
tools/out/preview.step
352.7 x 234.7 x 89.9 mm
HÃ¡z (alu) Â· HÃ¡z x 2
HÃ¡tsÃ³ kupak (PC) Â· Kupak x 2
FedÅÃ¼veg Â· FedÅÃ¼veg x 2
OrrkÃºp (PEEK) Â· OrrkÃºp x 2
HV bÃ©lÃ©s (PEEK) Â· HV bÃ©lÃ©s x 2
BetÃ©t (PEI) Â· BetÃ©t x 2
Gomb Â· Gomb x 2
ÃveggyÅ±rÅ± Â· ÃveggyÅ±rÅ± x 2
LED 405 nm Â· LED 405 nm x 2
LED 405 nm Â· LED 405 nm 2 x 2
LED 405 nm Â· LED 405 nm 3 x 2
LED 660 nm Â· LED 660 nm x 2
LED 660 nm Â· LED 660 nm 2 x 2
LED 660 nm Â· LED 660 nm 3 x 2
Kamera (OV5640) Â· ObjektÃv x 2
Kamera (OV5640) Â· SzÅ±rÅ x 2
Kamera (OV5640) Â· Modul x 2
Kamera (OV5640) Â· Szenzor NYÃK x 2
CeraPlas HF Â· Piezo x 2
CeraPlas HF Â· TÃ¼ske 1 x 2
CeraPlas HF Â· TÃ¼ske 2 x 2
CeraPlas HF Â· TÃ¼sketartÃ³ x 2
CeraPlas HF Â· BÃ¶lcsÅ x 2
ÃrnyÃ©kolÃ¡s Â· ÃrnyÃ©kolÃ¡s x 2
Plazma NYÃK Â· NYÃK x 2
Plazma NYÃK Â· TÃ¼ske pad 1 x 2
Plazma NYÃK Â· TÃ¼ske pad 2 x 2
Plazma NYÃK Â· FET 1 x 2
Plazma NYÃK Â· FET 2 x 2
Plazma NYÃK Â· Gate driver x 2
Plazma NYÃK Â· STM32G474 x 2
Plazma NYÃK Â· RezonÃ¡ns tekercs x 2
Plazma NYÃK Â· HÃd kondenzÃ¡tor 1 x 2
Plazma NYÃK Â· HÃd kondenzÃ¡tor 1 vÃ©gelektrÃ³da 1 x 2
Plazma NYÃK Â· HÃd kondenzÃ¡tor 1 vÃ©gelektrÃ³da 2 x 2
Plazma NYÃK Â· HÃd kondenzÃ¡tor 2 x 2
Plazma NYÃK Â· HÃd kondenzÃ¡tor 2 vÃ©gelektrÃ³da 1 x 2
Plazma NYÃK Â· HÃd kondenzÃ¡tor 2 vÃ©gelektrÃ³da 2 x 2
Plazma NYÃK Â· 12 V kondenzÃ¡tor 1 x 2
Plazma NYÃK Â· 12 V kondenzÃ¡tor 1 vÃ©gelektrÃ³da 1 x 2
Plazma NYÃK Â· 12 V kondenzÃ¡tor 1 vÃ©gelektrÃ³da 2 x 2
Plazma NYÃK Â· 12 V kondenzÃ¡tor 2 x 2
Plazma NYÃK Â· 12 V kondenzÃ¡tor 2 vÃ©gelektrÃ³da 1 x 2
Plazma NYÃK Â· 12 V kondenzÃ¡tor 2 vÃ©gelektrÃ³da 2 x 2
Plazma NYÃK Â· ÃtkÃ¶tÅ flex x 2
VentilÃ¡tor Â· HÃ¡z x 2
VentilÃ¡tor Â· Rotor agy x 2
VezÃ©rlÅ hÃd Â· NYÃK x 2
VezÃ©rlÅ hÃd Â· ISO7741 x 2
VezÃ©rlÅ hÃd Â· ISO7741 lÃ¡b P1 x 2
VezÃ©rlÅ hÃd Â· ISO7741 lÃ¡b P2 x 2
VezÃ©rlÅ hÃd Â· ISO7741 lÃ¡b P3 x 2
VezÃ©rlÅ hÃd Â· ISO7741 lÃ¡b P4 x 2
VezÃ©rlÅ hÃd Â· ISO7741 lÃ¡b P5 x 2
VezÃ©rlÅ hÃd Â· ISO7741 lÃ¡b P6 x 2
VezÃ©rlÅ hÃd Â· ISO7741 lÃ¡b P7 x 2
VezÃ©rlÅ hÃd Â· ISO7741 lÃ¡b P8 x 2
VezÃ©rlÅ hÃd Â· ISO7741 lÃ¡b A1 x 2
VezÃ©rlÅ hÃd Â· ISO7741 lÃ¡b A2 x 2
VezÃ©rlÅ hÃd Â· ISO7741 lÃ¡b A3 x 2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
