pattyka/plasmapen-nexus/(commit log)

2026-10-21 PlasmaPen Nexus parametric Fusion model: unibody spindle, render scene + engineering cutaway
    [preview.step]
2026-10-21 Revision 4: two-part device — chamfered aluminium shell with display and dock flats, PEI insert with isolated plasma/AI boards, 1.91in touch AMOLED
    [preview.step]
